Markahofmeister/PressurePulse_Brain-PCB/Project Outputs for PressurePulse_Brain-PCB/BOM/Bill of Materials-PressurePulse_Brain-PCB.xlsx

Comment | Designator | Footprint | JLCPCB PN
DNS | ANT1 | ANT_ANT7020LL05R0870A_PUL-L | DNS
BS-2-1 | BATT1 | BAT_BS-7 | C70376
100uF | C1 | CAP_POL_SMD | C336392
4.7uF | C2 | 0402C
4.7uF | C3 | 0402C
4.7uF | C4 | 0402C
100nF | C5 | 0402C
1uF | C6 | 0402C
1uF | C7 | 0402C
4.7uF | C8 | 0402C
4.7uF | C9 | 0402C
560pF | C10 | 0805C | C5186812
4.7uF | C11 | 0402C
22uF | C12 | 0805C | C45783
22uF | C13 | 0805C | C45783
4.7uF | C14 | 0402C
100nF | C15 | 0402C
100nF | C16 | 0402C
100nF | C17 | 0402C
1uF | C18 | 0402C
1uF | C19 | 0402C
100nF | C20 | 0402C
100nF | C21 | 0402C
4.7uF | C22 | 0402C
100nF | C23 | 0402C
0.8pF | C24 | 0603C | C907996
0.3pF | C25 | 0402C | C2986289
DNS | C26 | 0402C
10pF | C27 | 0402C | C328913
DNS | C28 | 0402C
10pF | C29 | 0402C | C328913
4.7uF | C30 | 0402C
100nF | C31 | 0402C
4.7uF | C32 | 0402C
560pF | C33 | 0402C
560pF | C34 | 0402C
4.7uF | C35 | 0402C
100nF | C36 | 0402C
100nF | C37 | 0402C
4.7uF | C38 | 0402C
100uF | C39 | CAP_POL_SMD | C336392
100uF | C40 | CAP_POL_SMD | C336392
4.7uF | C41 | 0402C
4.7uF | C42 | 0402C
4.7uF | C43 | 0402C
SSL24F | D1 | SMAF | C4749014
19-213/Y2C-CQ2R2L/3T(CY) | D3 | 0603-LED | C72038
D-060306B1 | D4 | 0603-LED | C118339
KT-0603R | D5 | 0603-LED | C2286
BDFN2C051V40 | D6 | BDFN2C051V40 | C152023
BDFN2C051V40 | D7 | BDFN2C051V40 | C152023
BDFN2C051V40 | D8 | BDFN2C051V40 | C152023
BDFN2C051V40 | D9 | BDFN2C051V40 | C152023
BDFN2C051V40 | D10 | BDFN2C051V40 | C152023
BDFN2C051V40 | D11 | BDFN2C051V40 | C152023
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
TPS613222ADBVR | U5 | SOT-23-5 | C2071163
STM32WB55RGV6 | U6 | VQFN-68 | C401505
MAX98357AETE+T | U7 | 16-WFQFN EXPOSED PAD | C910544
LIS3DHTR | U8 | 16-VFLGA | C15134
XRCMD32M000FXP50R0 | X1 | 32MHZ_SMD1612-4P | C341820
CM315D32768DZFT | X2 | XTAL_ECS-.327-12.5-34B-TR | C182057
