Markahofmeister/PressurePulse_Brain-PCB/PressurePulse_Brain-PCB.pdf

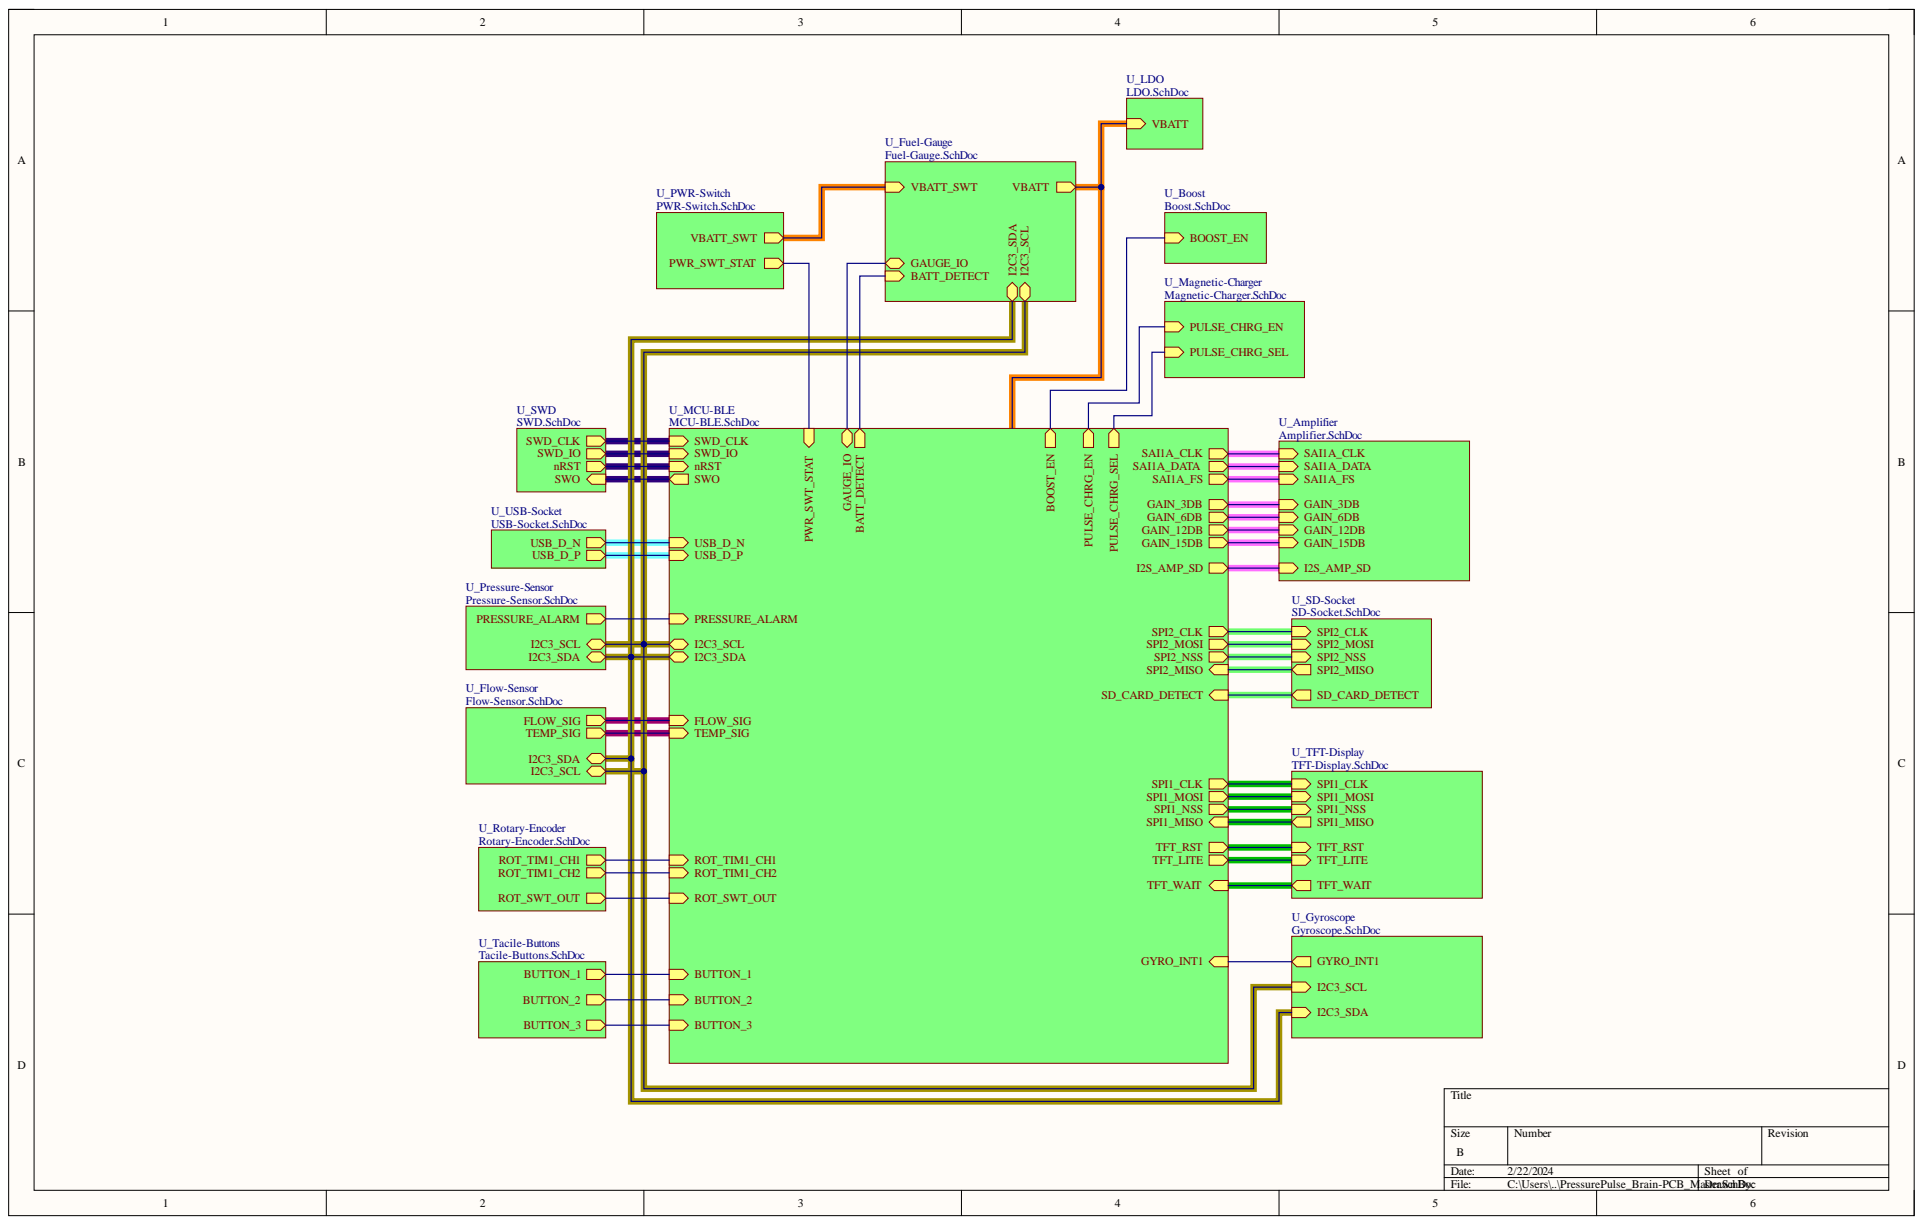
[picture p1: page 1]

Size B | Number | Revision

Date: 2/22/2024 | Sheet of
File: C:\Users\..\PressurePulse_Brain-PCB_MaDsterawr.Scn hBDy: oc

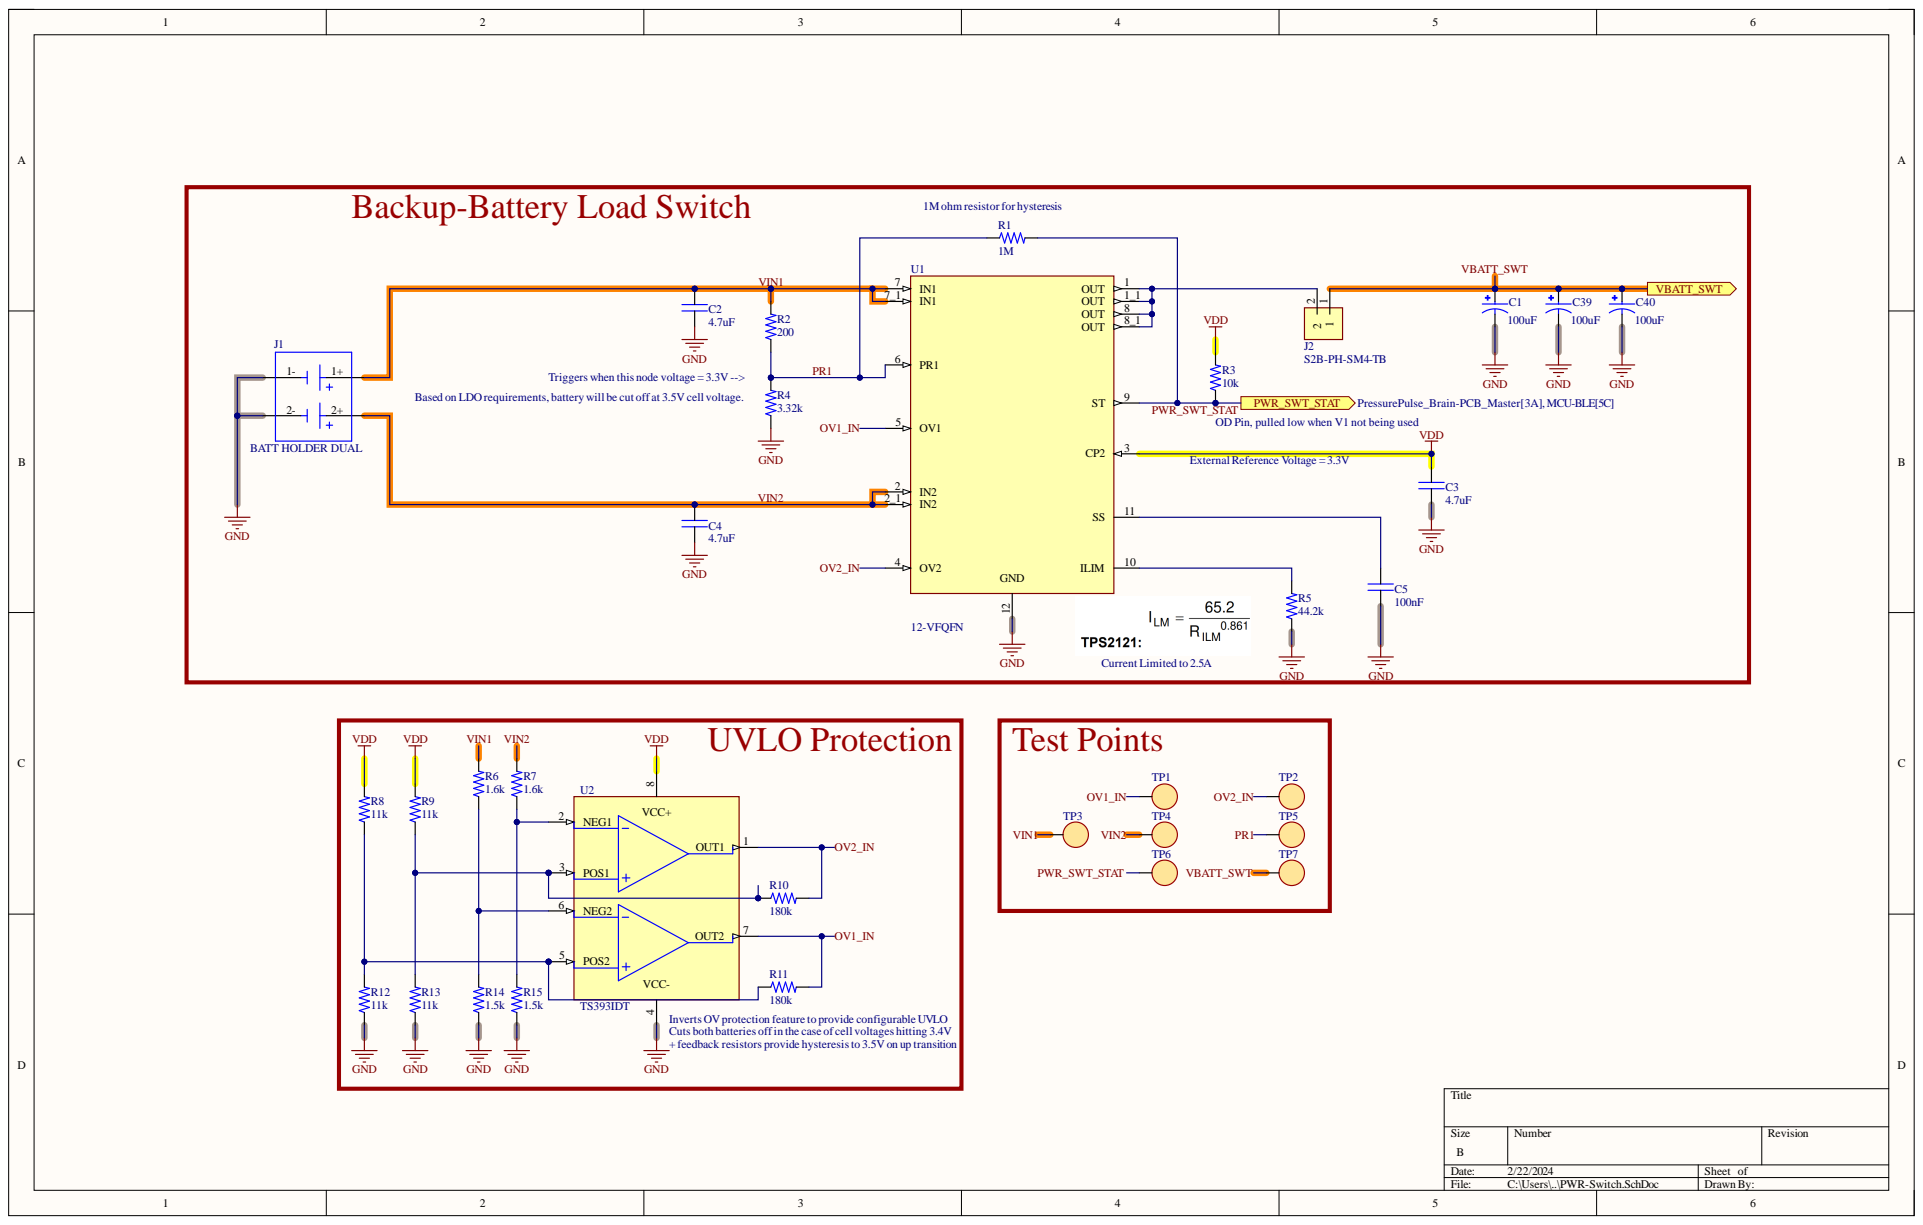
[picture p2: page 2]

Backup-Battery Load Switch

Triggers when this node voltage =3.3V -->

Based on LDOrequirements, battery will be cut off at 3.5V cell voltage.

OD Pin, pulled low when V1 not being used

Inverts OVprotection feature to provide configurable UVLO
Cuts both batteries off in the case of cell voltages hitting 3.4V
+feedback resistors provide hysteresisto 3.5V on up transition

Size B | Number | Revision

Date: 2/22/2024 | Sheet of
File: C:\Users\..\PWR-Switch.SchDoc | Drawn By:

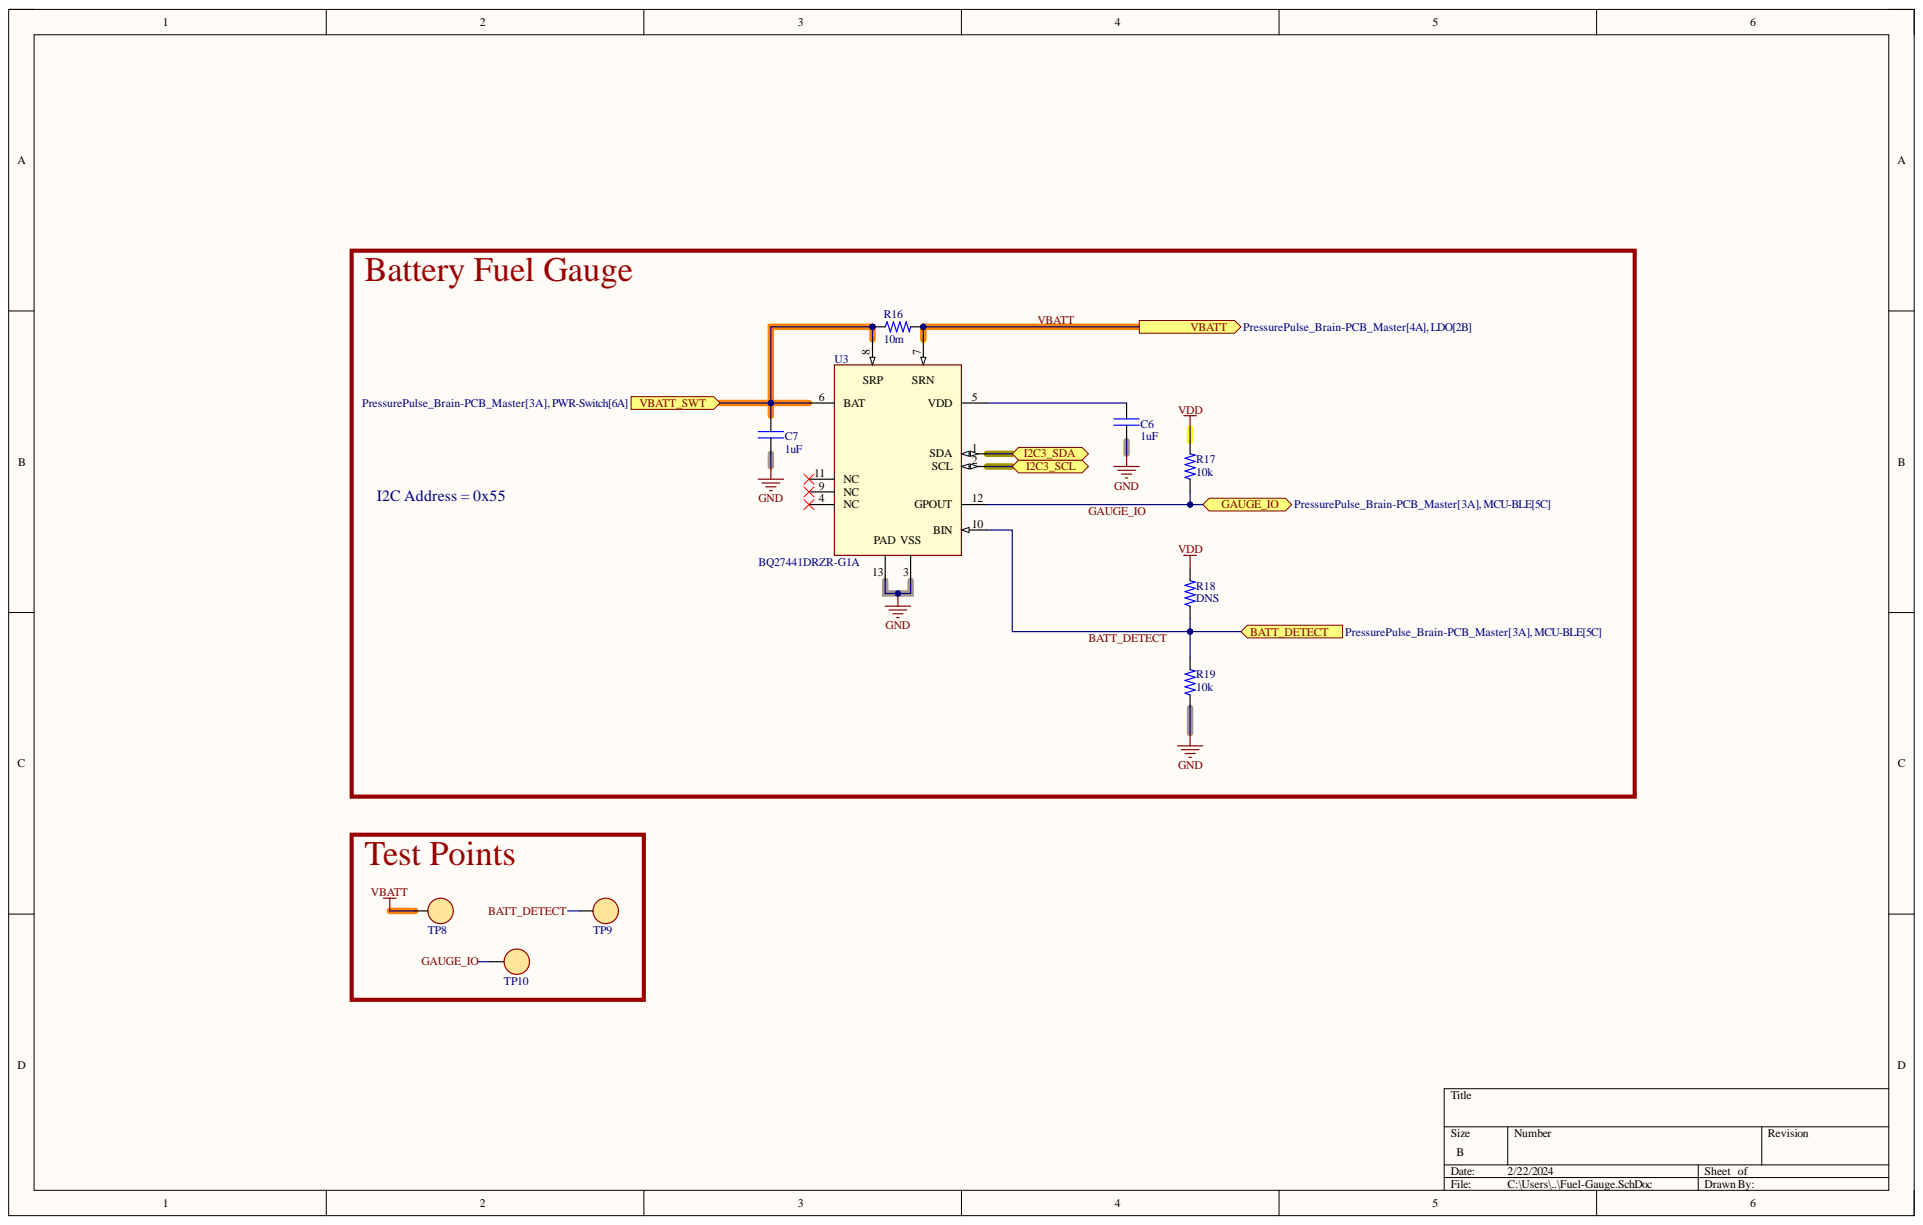
[picture p3: page 3]

Size B | Number | Revision

Date: 2/22/2024 | Sheet of
File: C:\Users\..\Fuel-Gauge.SchDoc | Drawn By:

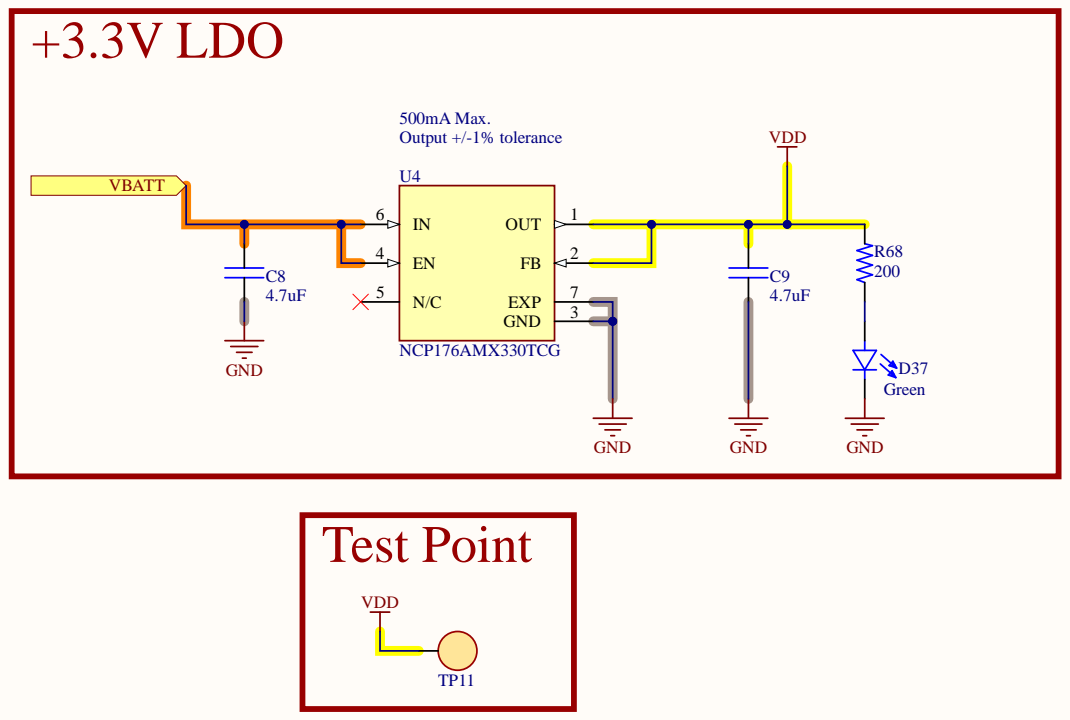
[picture p4: page 4]

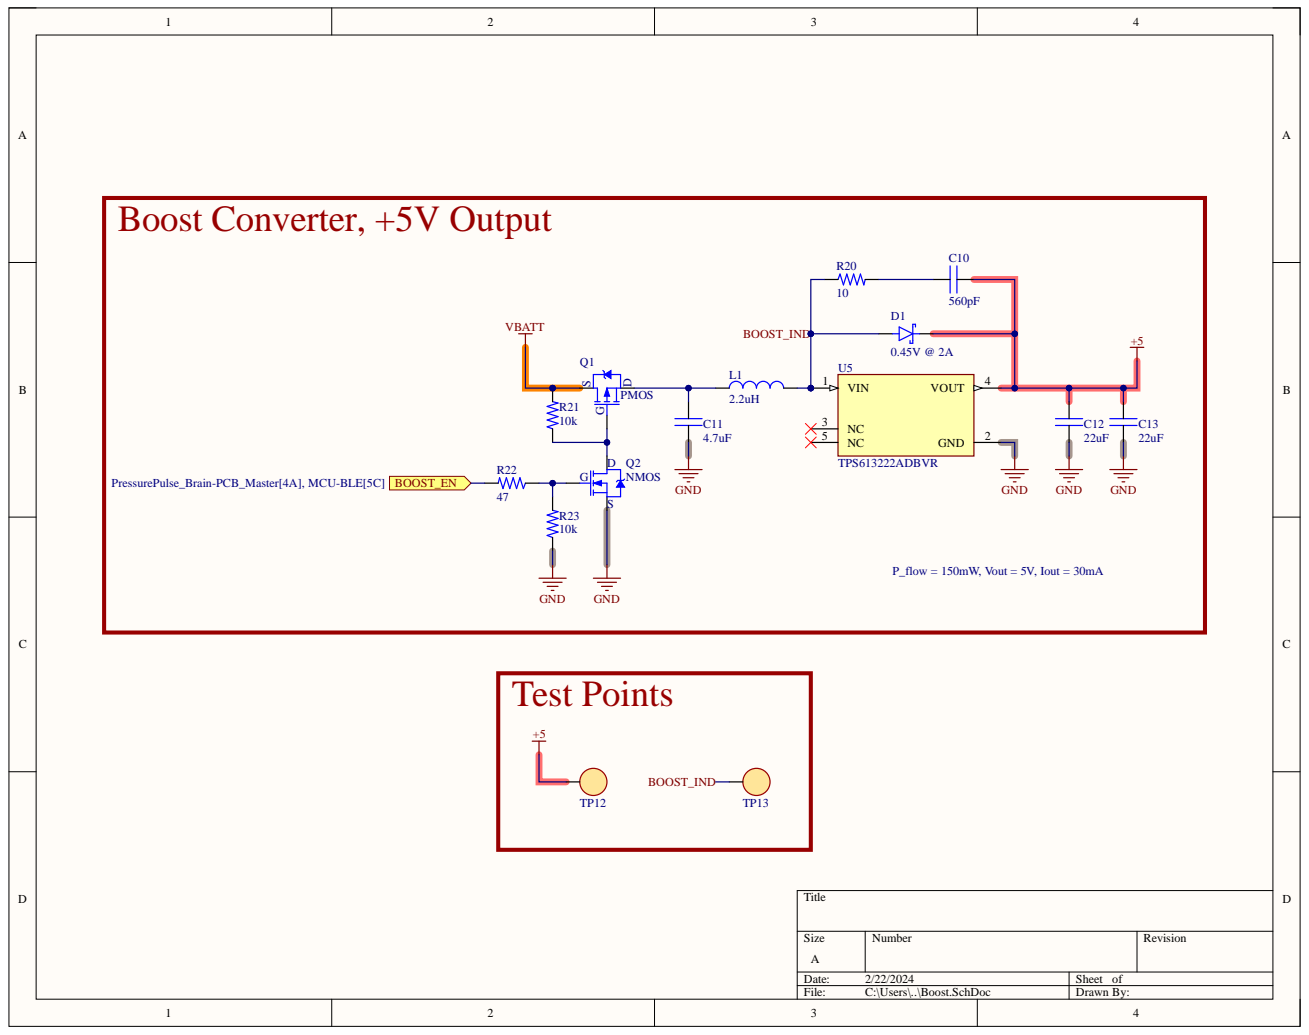
[picture p5: page 5]

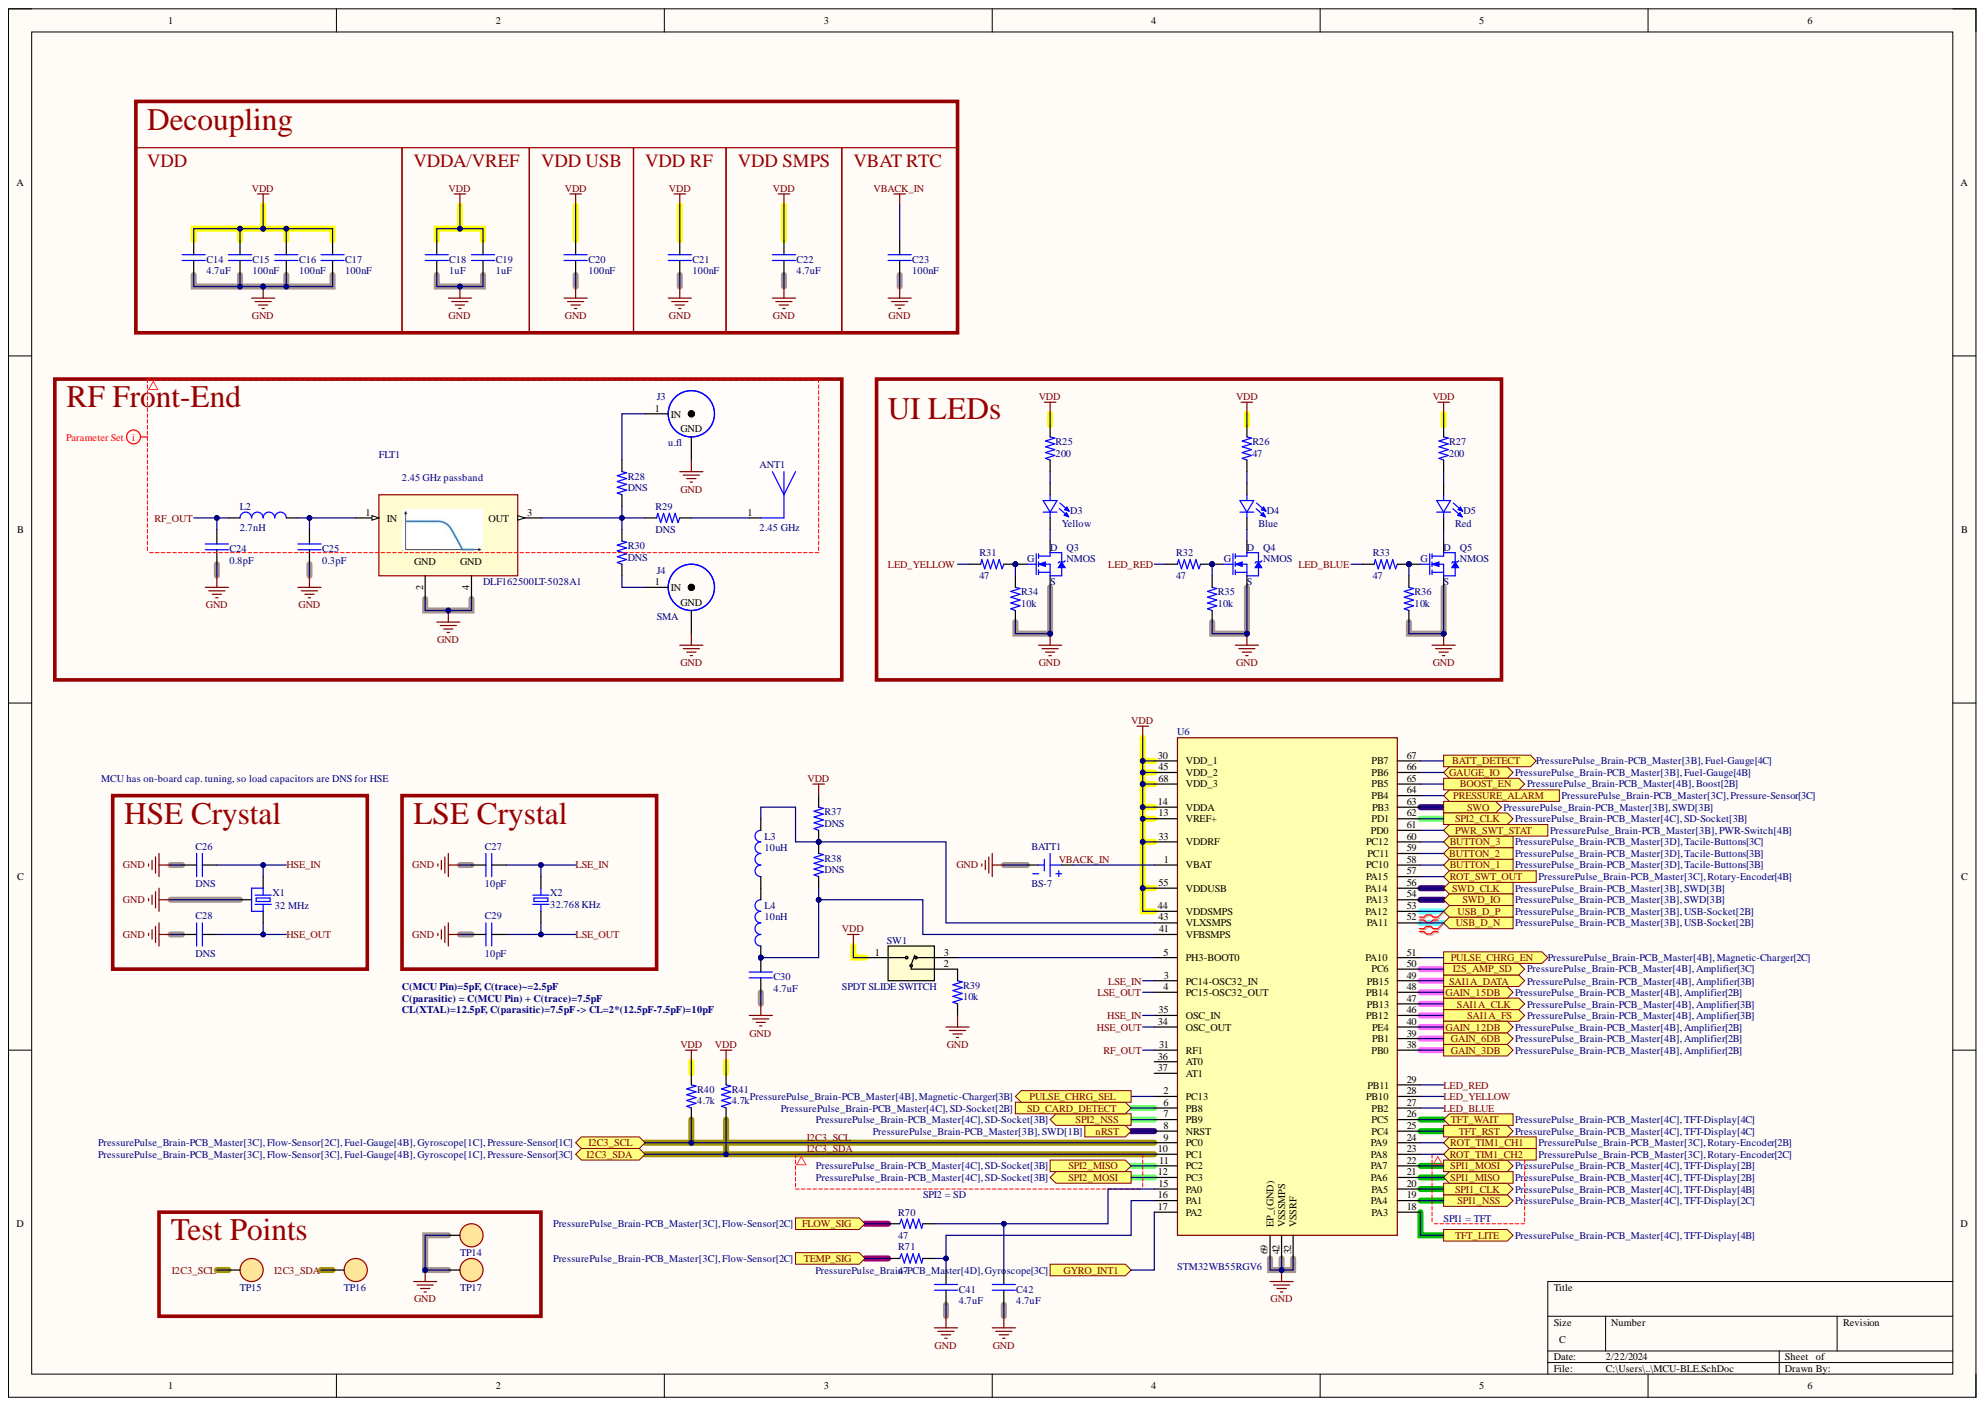
[picture p6: page 6]

MCU has on-board cap. tuning, so load capacitors are DNS for HSE

C(MCU Pin)=5pF, C(trace)~=2.5pF
C(parasitic) = C(MCU Pin) + C(trace)=7.5pF
CL(XTAL)=12.5pF, C(parasitic)=7.5pF -> CL=2*(12.5pF-7.5pF)=10pF

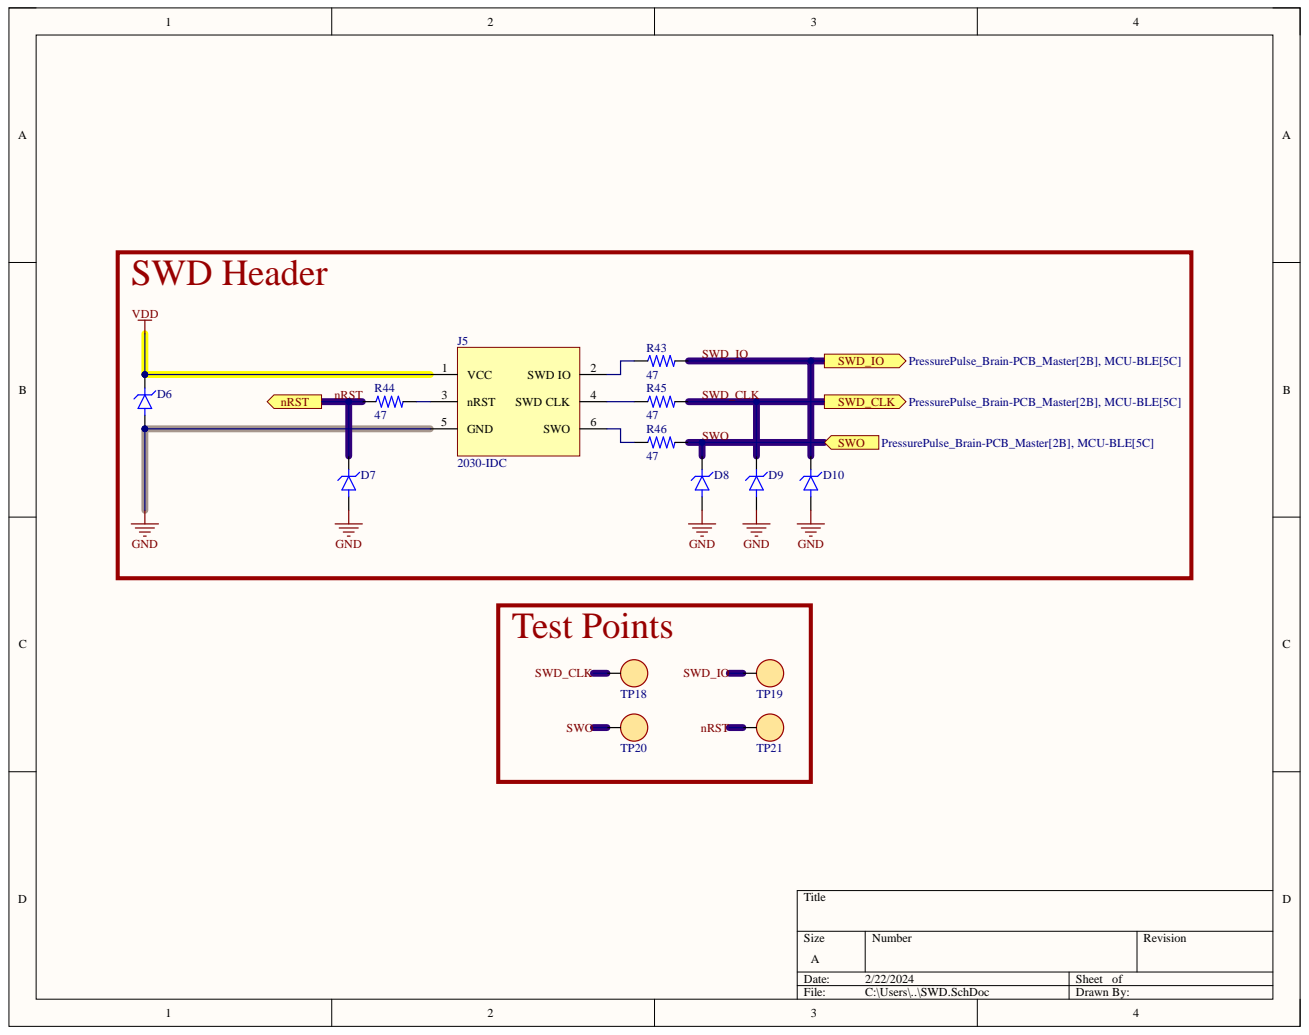
[picture p7: page 7]

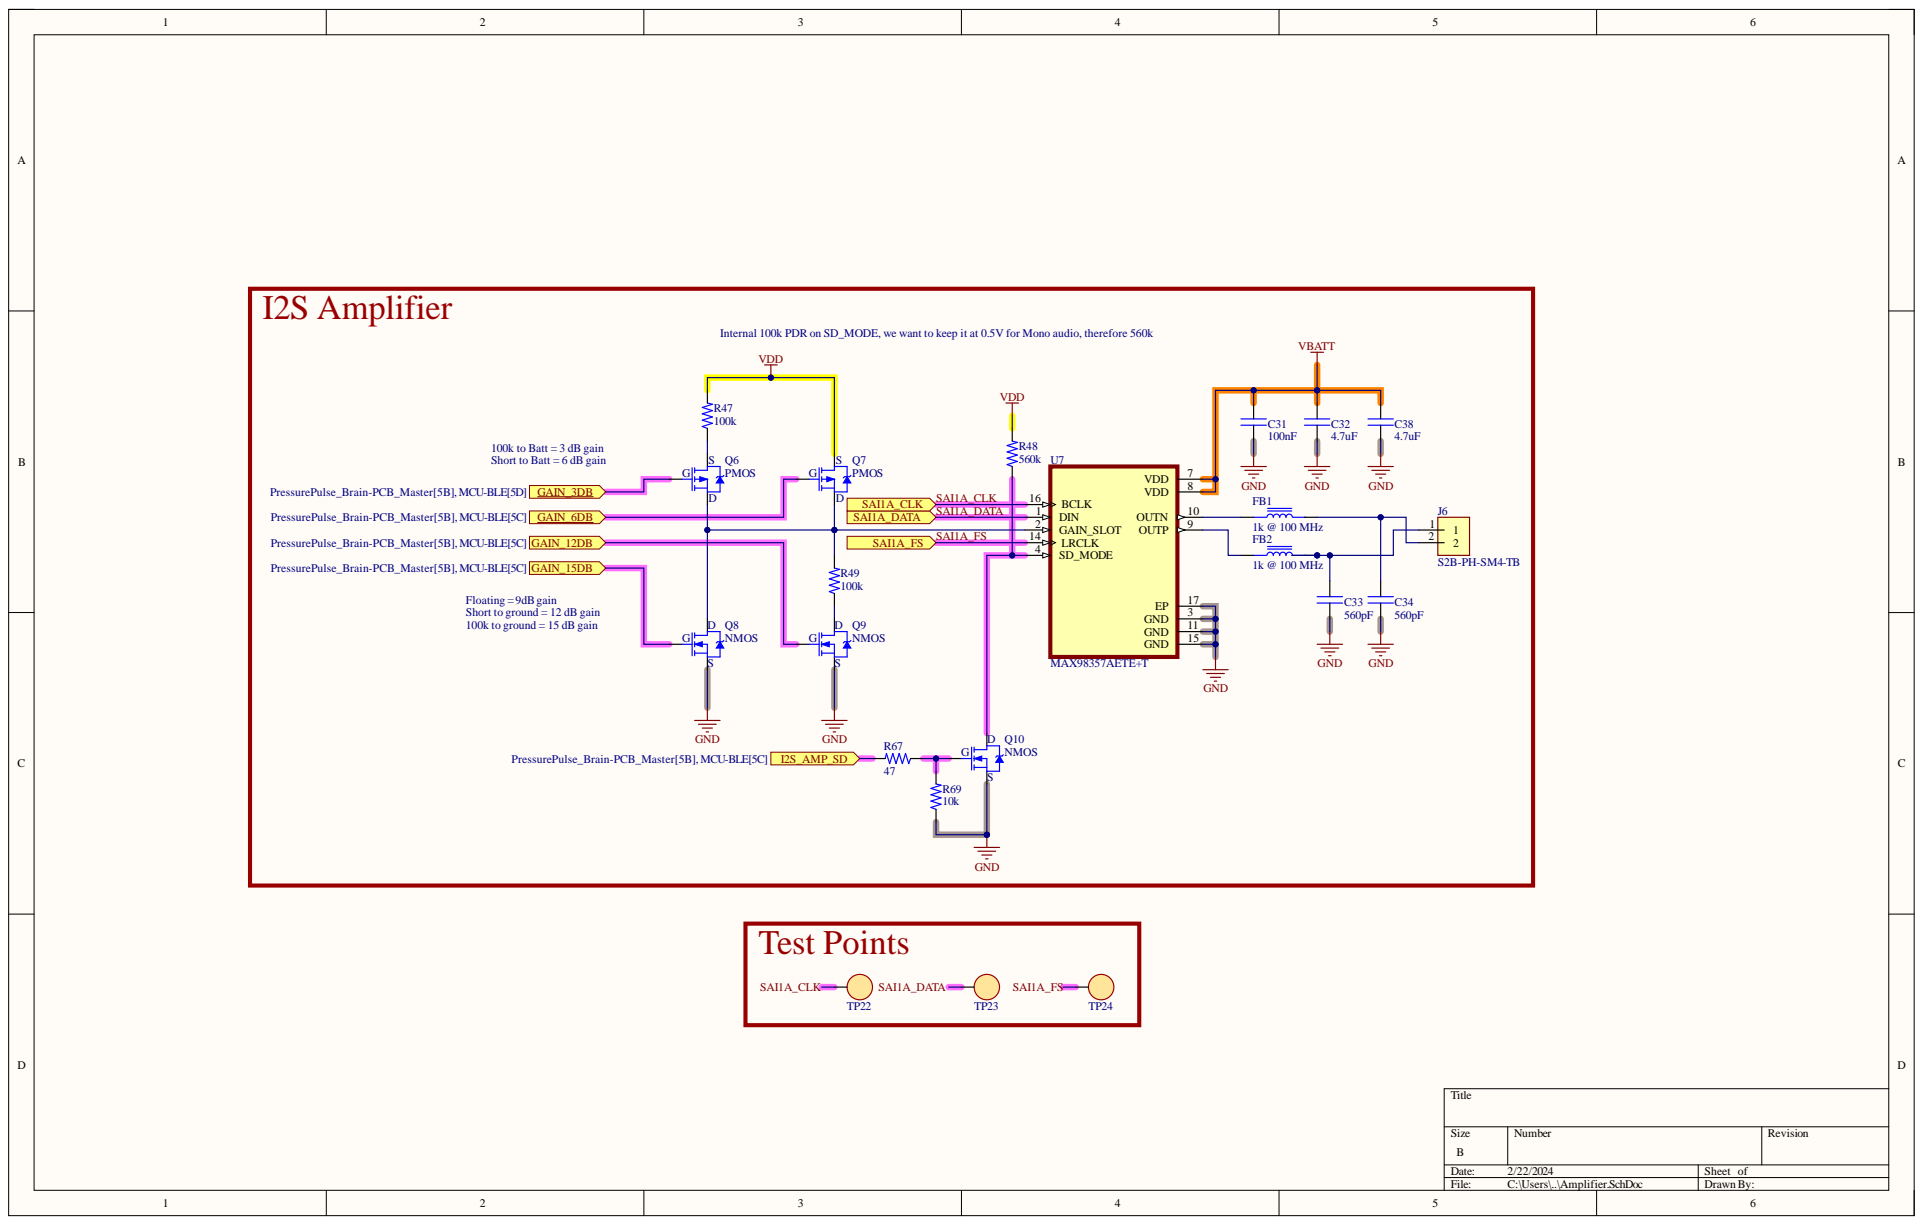
[picture p8: page 8]

Internal 100k PDR on SD_MODE, we want to keep it at 0.5V for Mono audio, therefore 560k

100k to Batt = 3 dB gain
Short to Batt = 6 dB gain

Floating =9dBgain
Short to ground = 12 dB gain
100k to ground = 15 dB gain

Size B | Number | Revision

Date: 2/22/2024 | Sheet of
File: C:\Users\..\Amplifier.SchDoc | Drawn By:

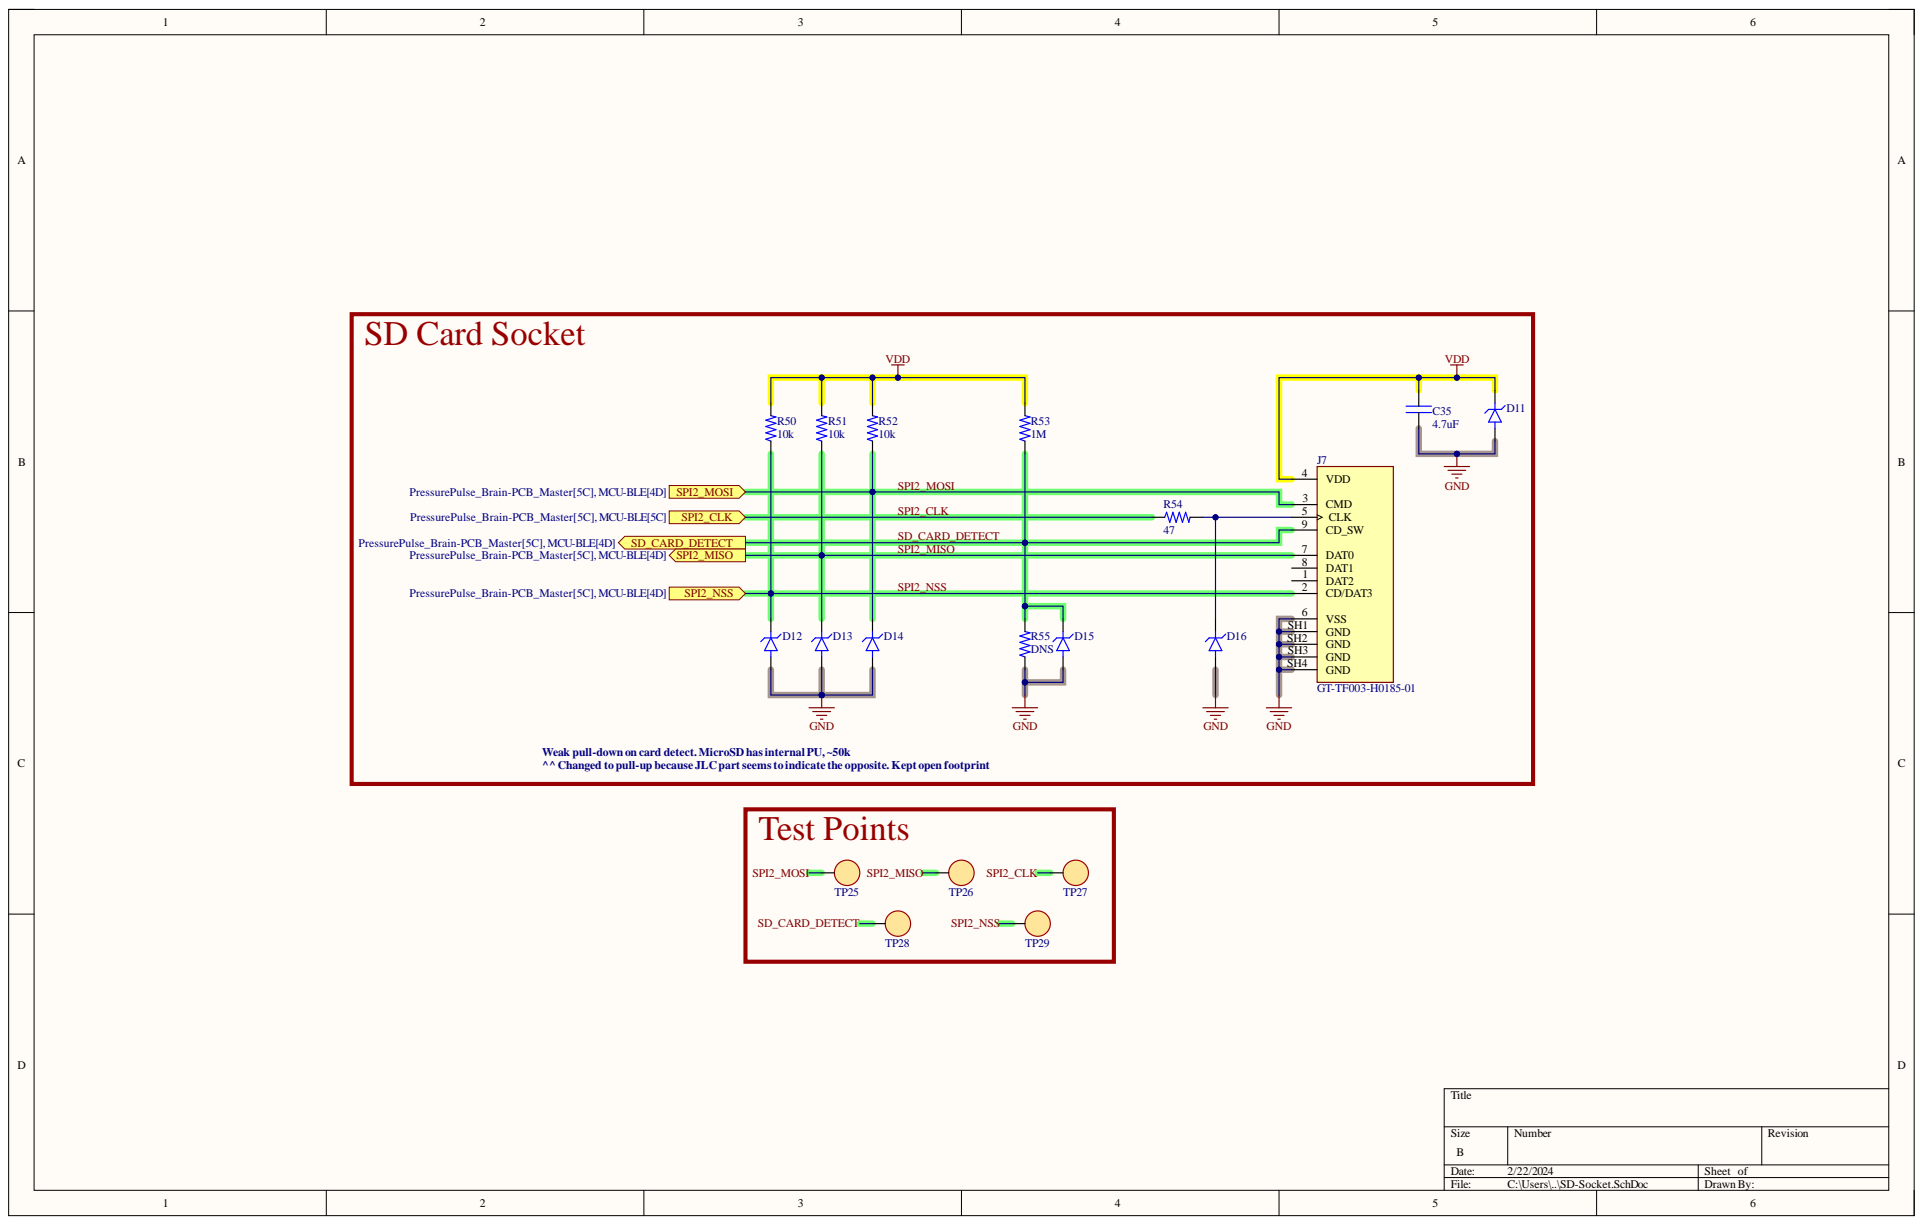
[picture p9: page 9]

SPI2_CLK SD_CARD_DETECT | | CLK 5 CD_SW 9

SPI2_MISO
SPI2_NSS | DAT1 8

DAT0 7

Weak pull-down on card detect. MicroSD hasinternal PU, ~50k
^^ Changed to pull-up because JLCpartseemsto indicate the opposite. Kept open footprint

Size B | Number | Revision

Date: 2/22/2024 | Sheet of
File: C:\Users\..\SD-Socket.SchDoc | Drawn By:

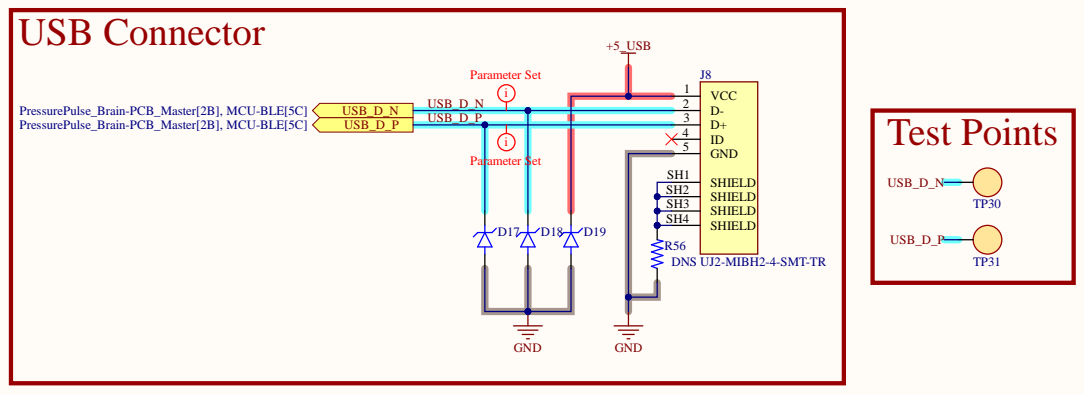
[picture p10: page 10]

S | H 1
S | H 2
S | H 3

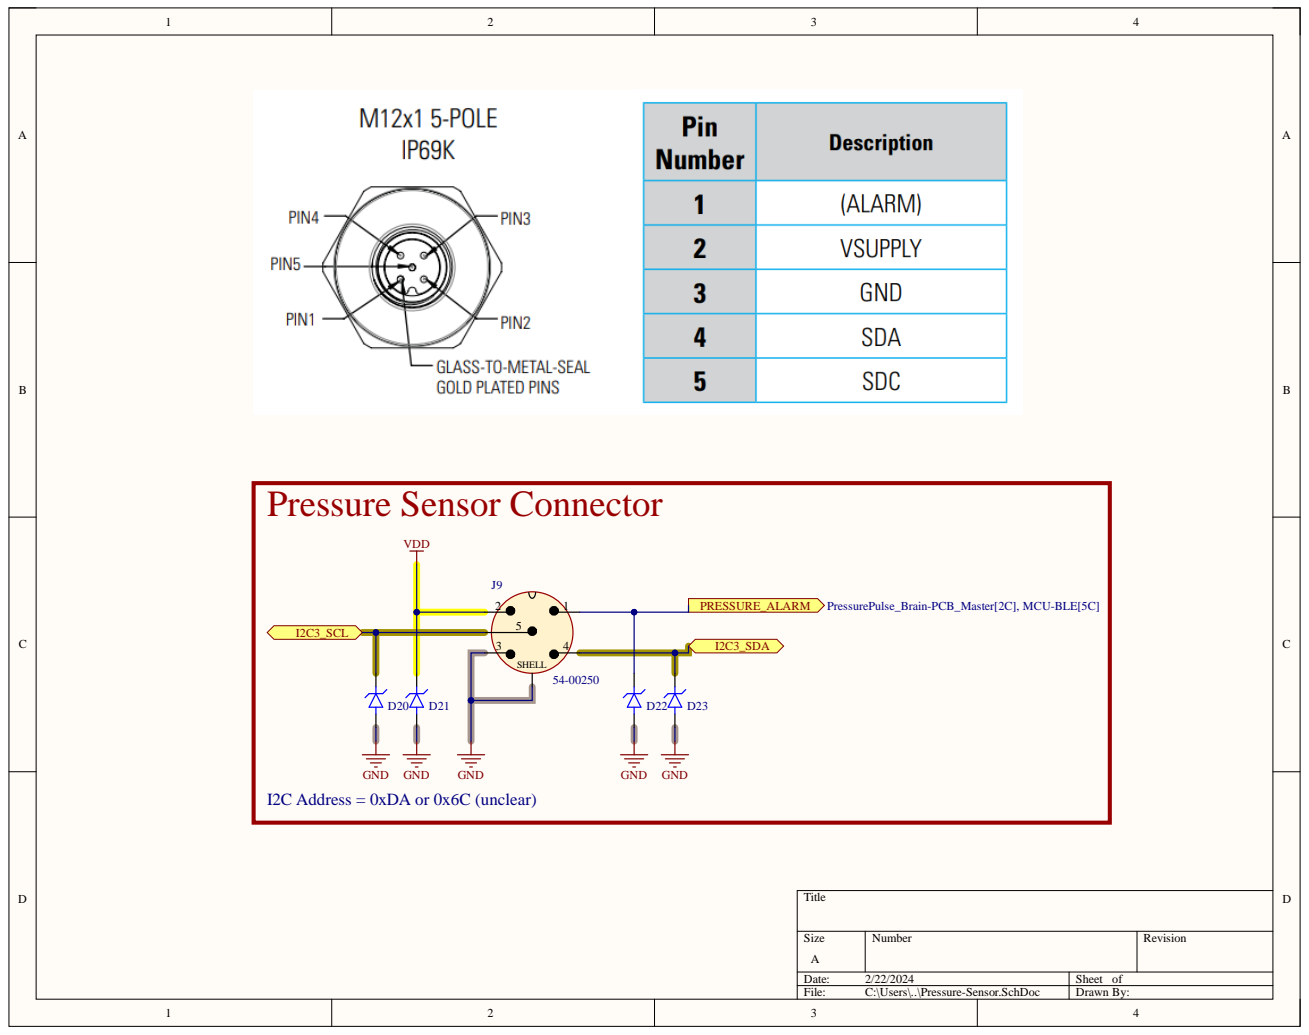
[picture p11: page 11]

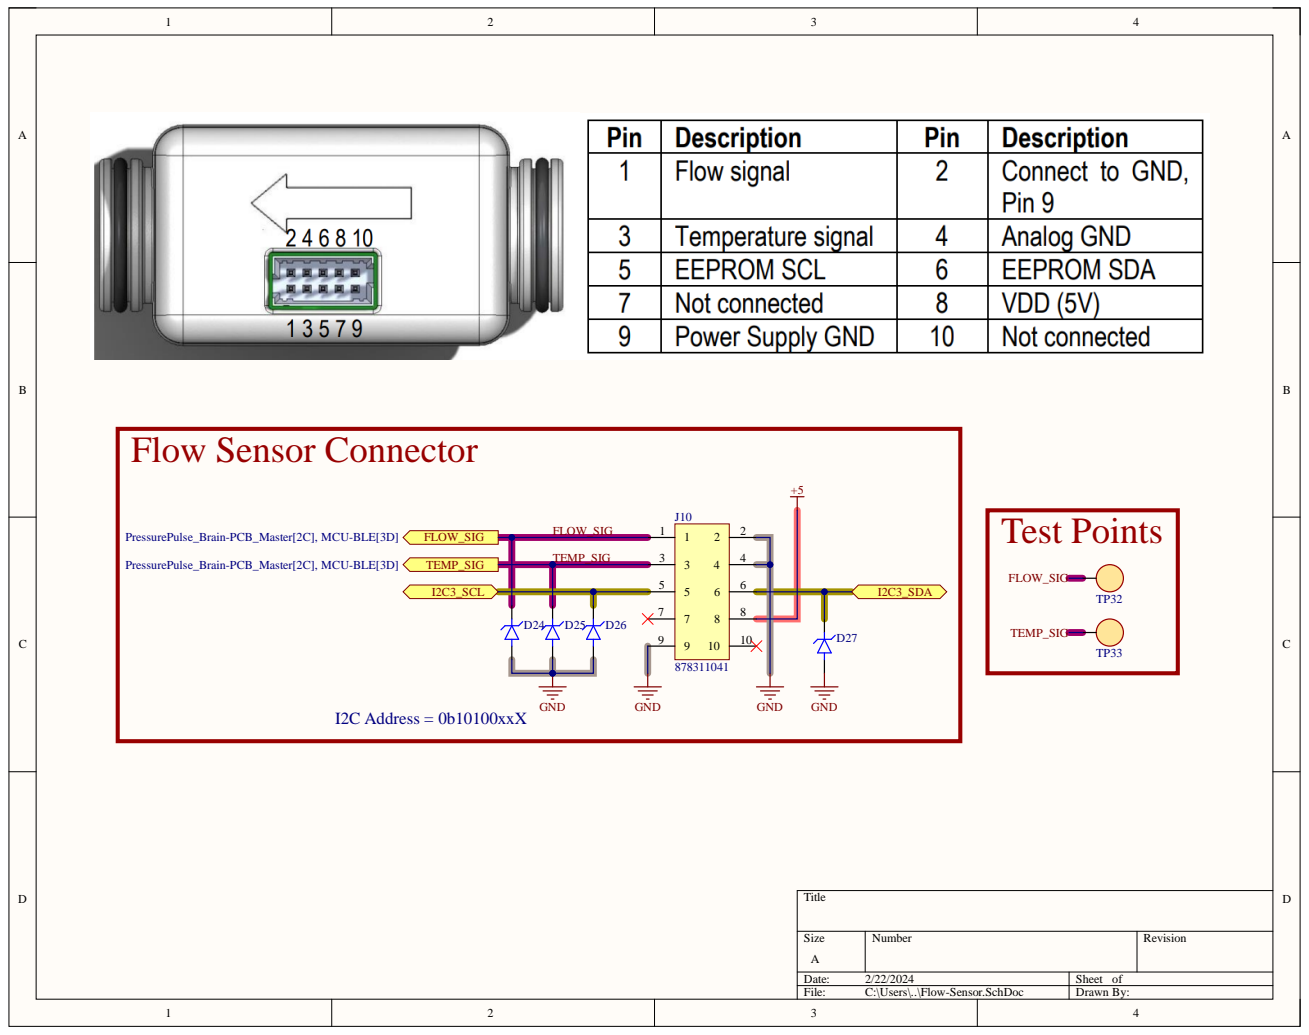
[picture p12: page 12]

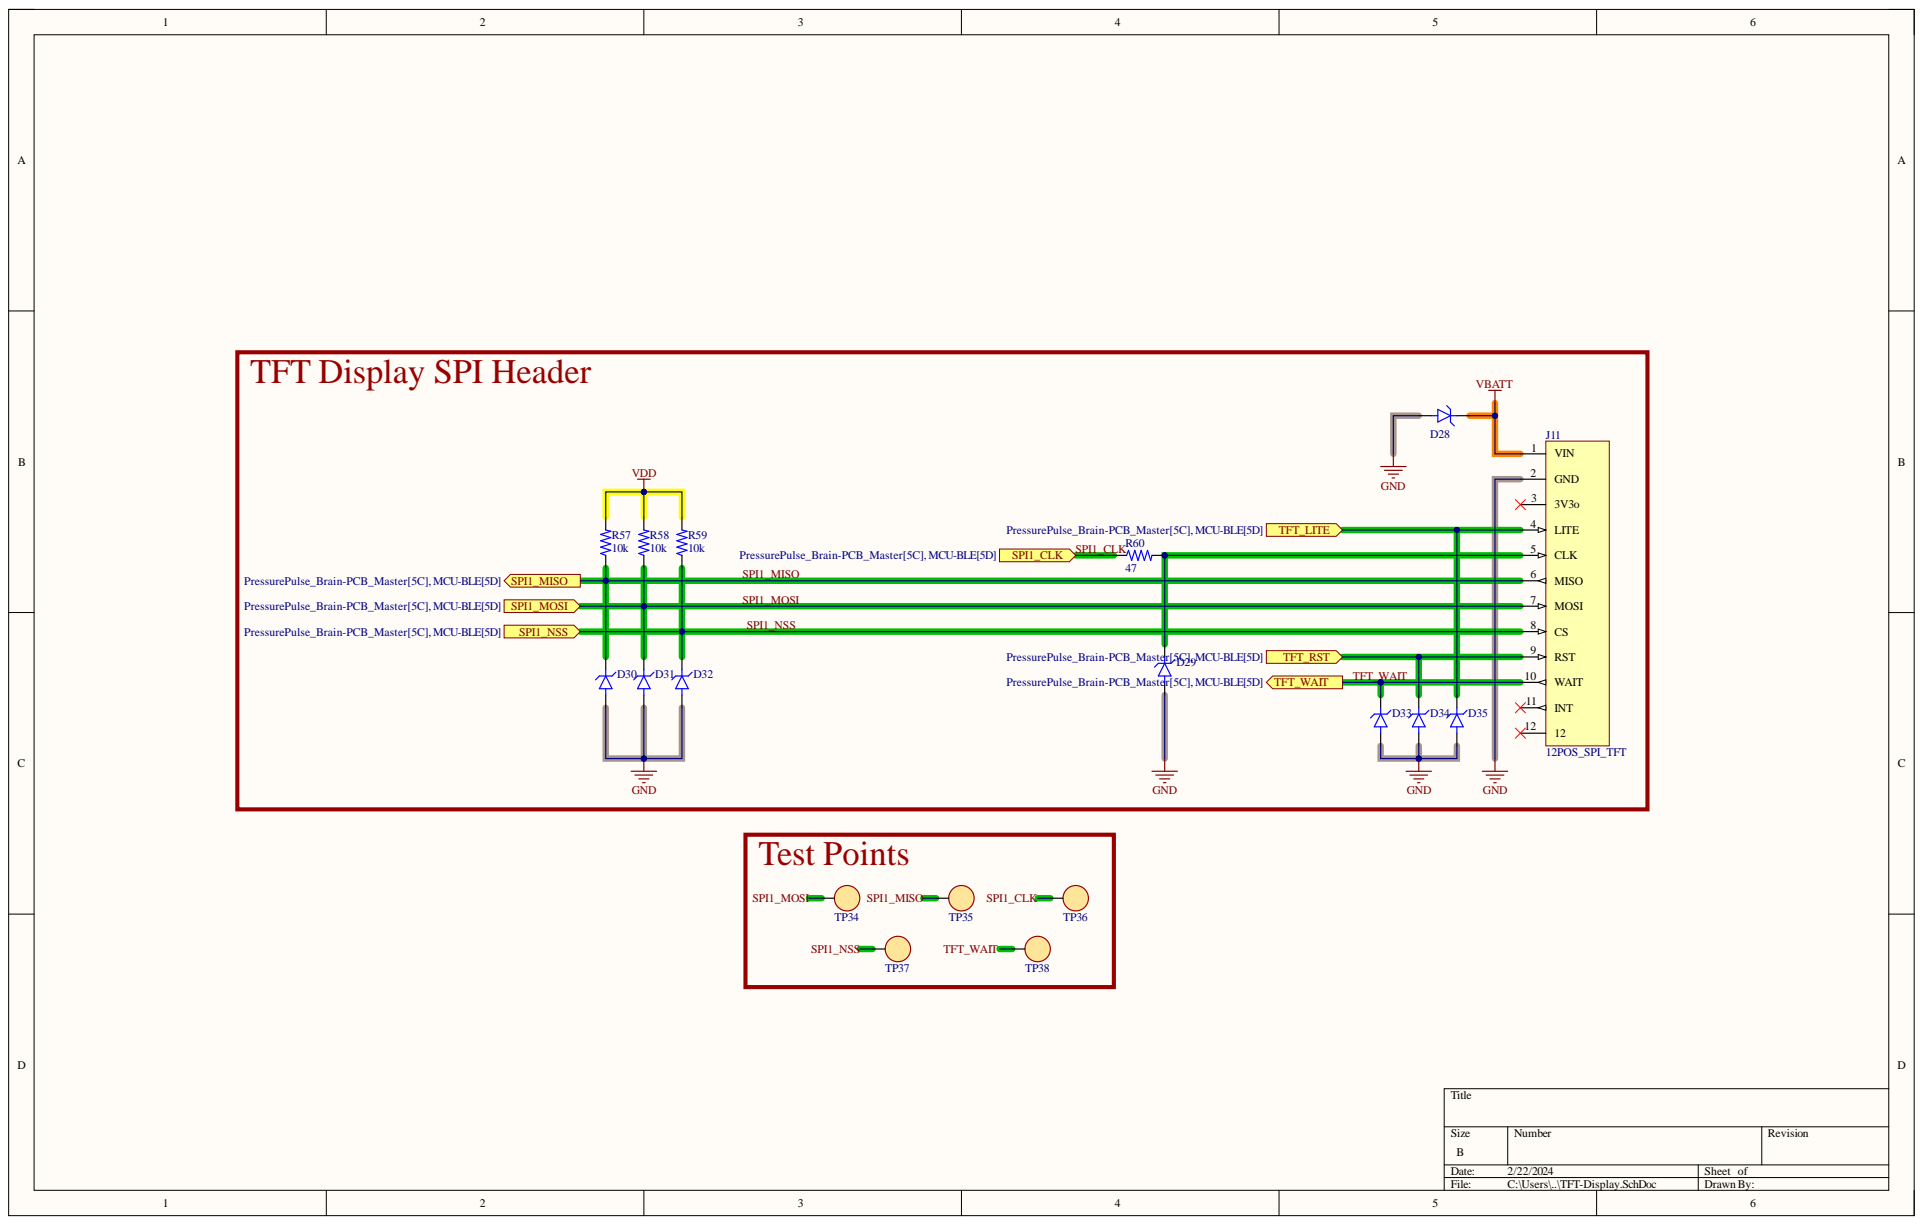
[picture p13: page 13]

TFT Display SPI Header

Size B | Number | Revision

Date: 2/22/2024 | Sheet of
File: C:\Users\..\TFT-Display.SchDoc | Drawn By:

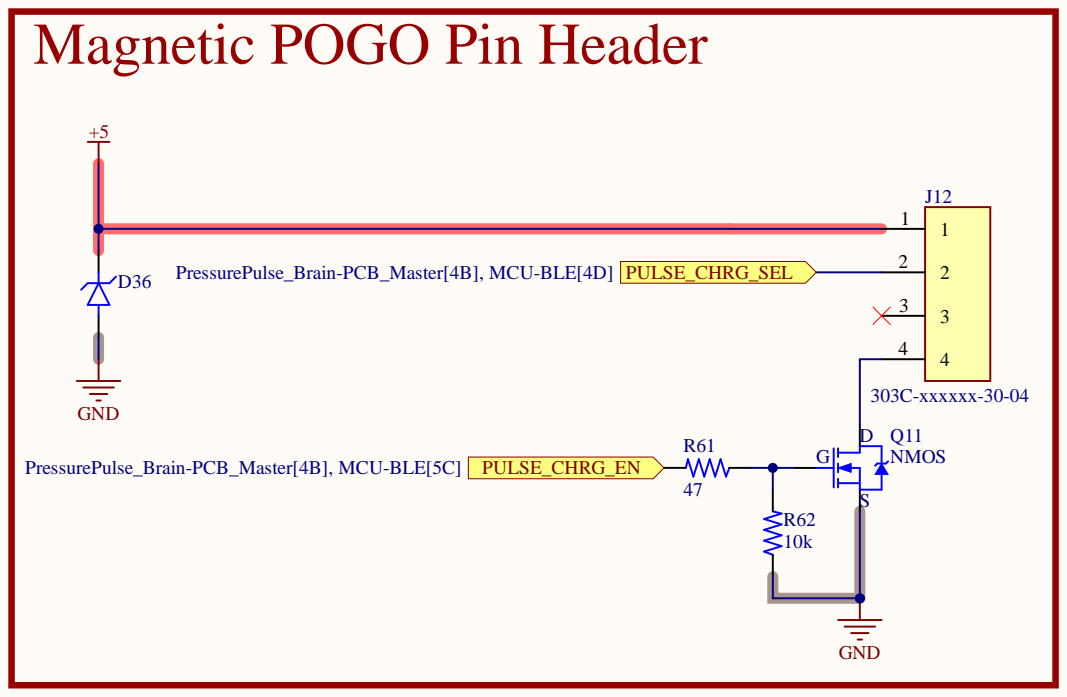
[picture p14: page 14]

Magnetic POGO Pin Header

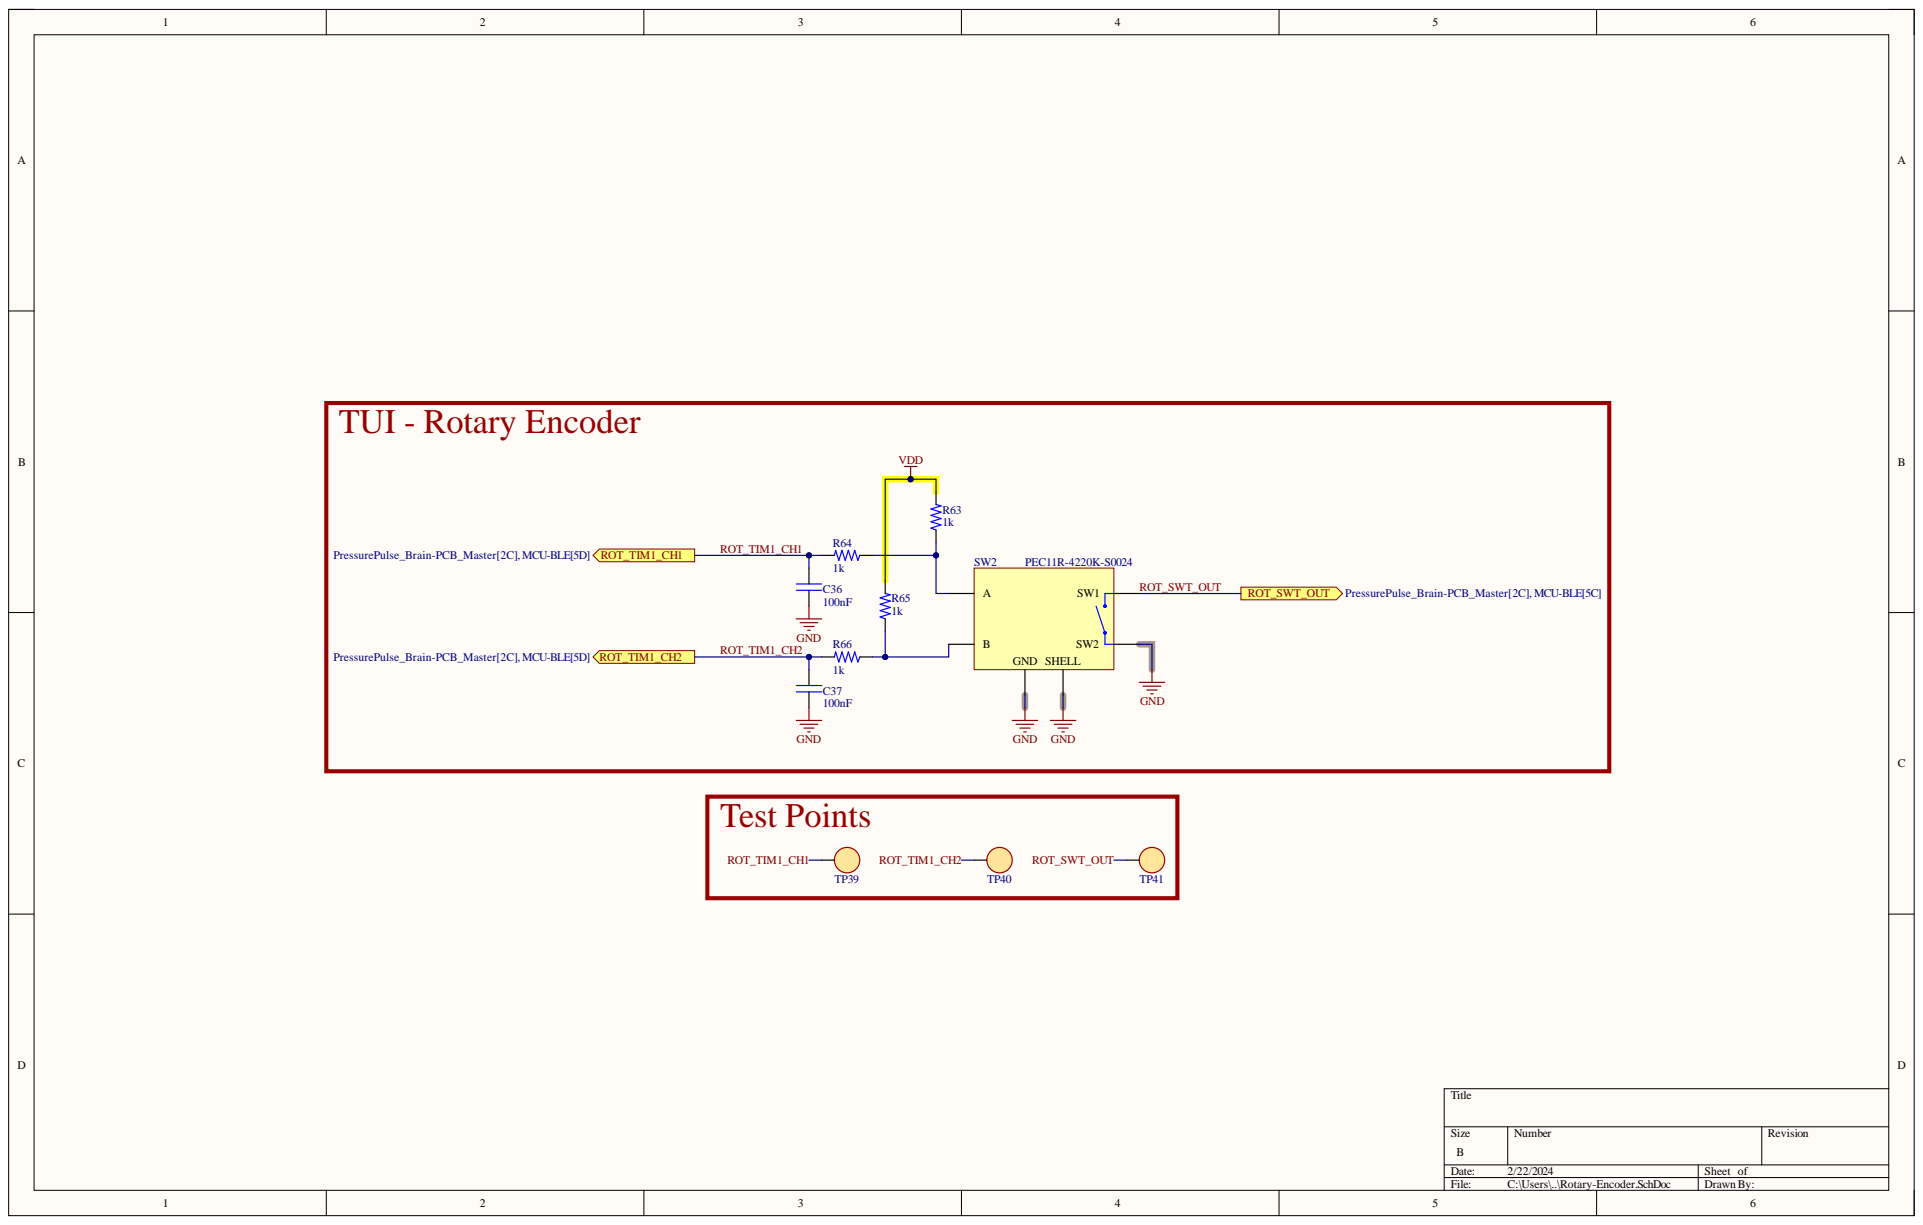
[picture p15: page 15]

Size B | Number | Revision

Date: 2/22/2024 | Sheet of
File: C:\Users\..\Rotary-Encoder.SchDoc | Drawn By:

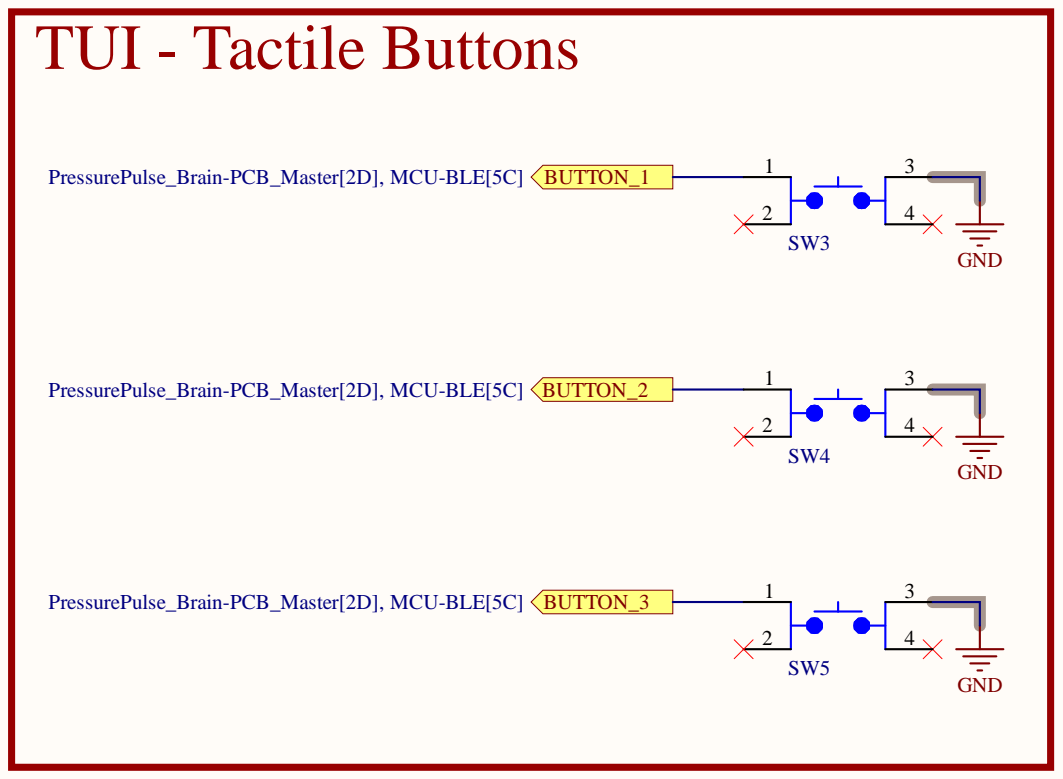
[picture p16: page 16]

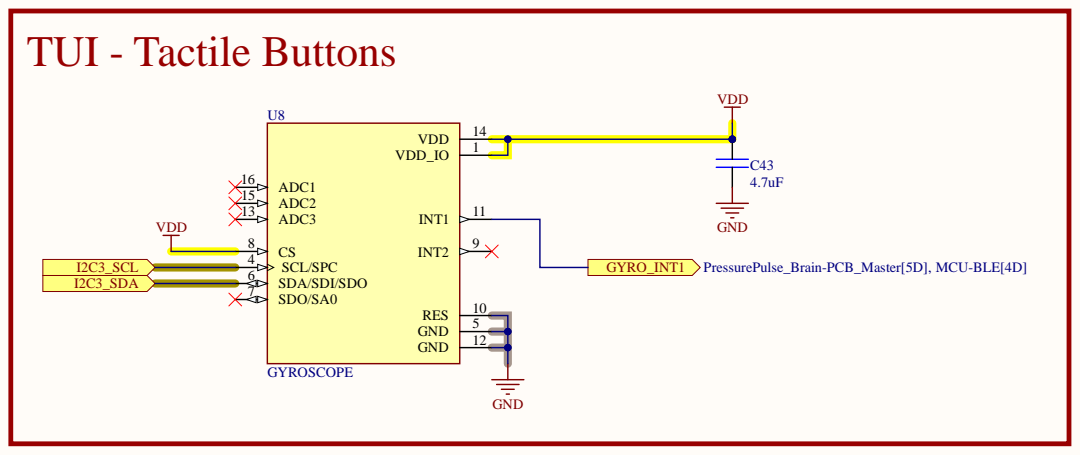
[picture p17: page 17]

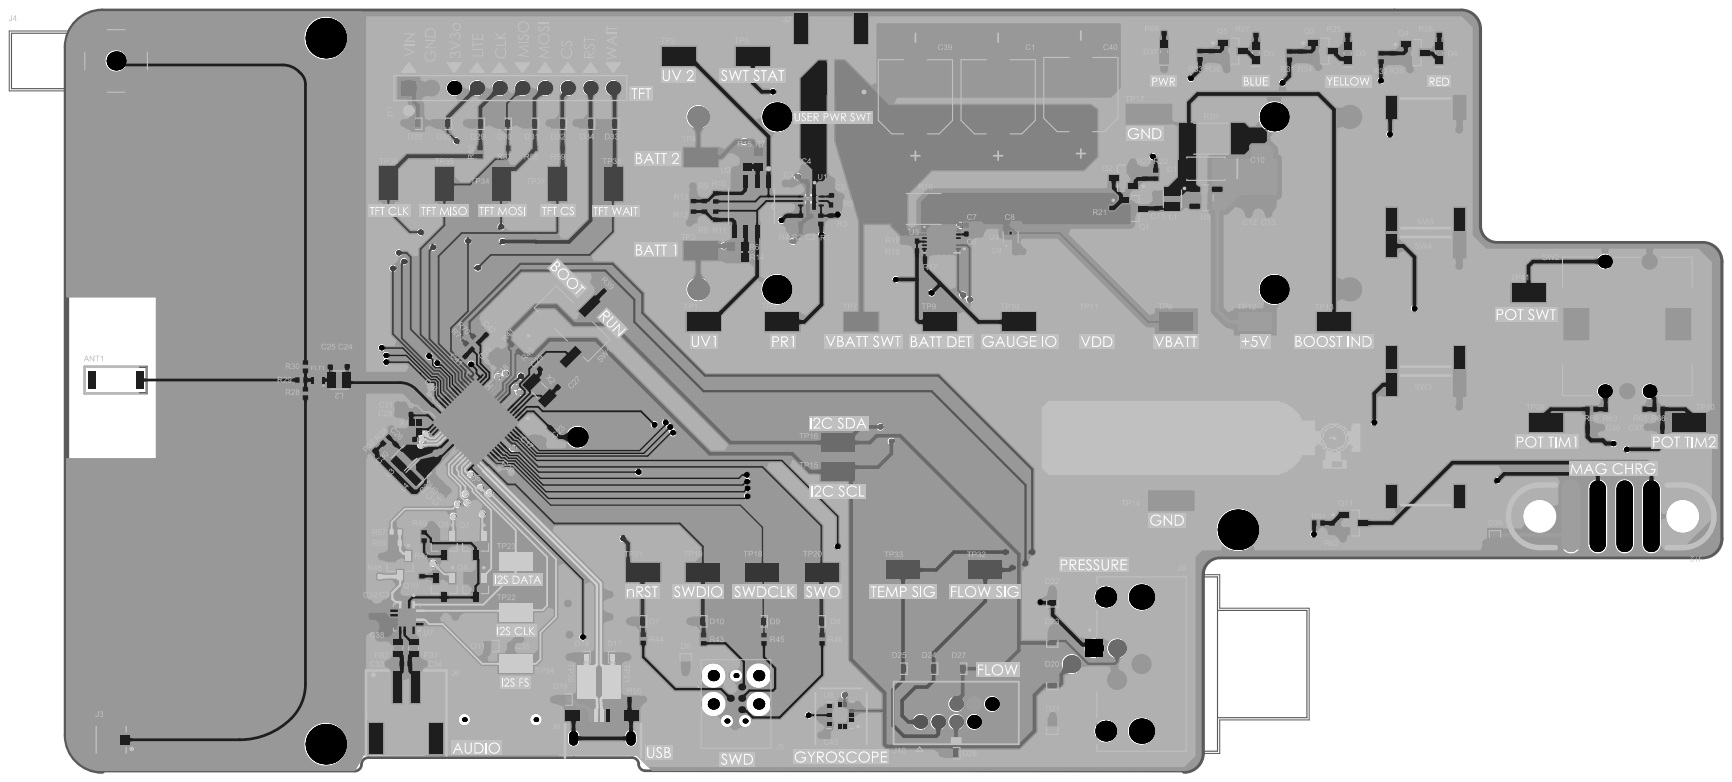
[picture p18: page 18]
