Markahofmeister/PressurePulse_Brain-PCB/(list of files, drawings)

Other design files:
6_USB-Socket.SchDoc
Amplifier.SchDoc
Boost.SchDoc
Flow-Sensor.SchDoc
Fuel-Gauge.SchDoc
Gyroscope.SchDoc
LDO.SchDoc
Magnetic-Charger.SchDoc
MCU-BLE.SchDoc
Pressure-Sensor.SchDoc
PressurePulse_Brain-PCB.PrjPcb
PressurePulse_Brain-PCB_Master.SchDoc
PWR-Switch.SchDoc
Rotary-Encoder.SchDoc
SD-Socket.SchDoc
SWD.SchDoc
Tacile-Buttons.SchDoc
TFT-Display.SchDoc
USB-Socket.SchDoc
