Markahofmeister/PressurePulse_Brain-PCB/(commit log)

2024-01-22 Initial Commit - Create Altium Project
    [PressurePulse_Brain-PCB.PrjPcb]
2024-01-22 Update .gitignore to ignore history
    [PressurePulse_Brain-PCB.PrjPcb]
2024-01-26 Add preliminary BLE MCU Schematic, may swap for lower pin count later
    [1_MCU-BLE.SchDoc, PressurePulse_Brain-PCB.PrjPcb]
2024-01-27 Add completed I2S amplifier. I will make this a hierarchical design
    [2_MCU-BLE.SchDoc]
2024-01-27 Finish SD card schem
    [4_Amplifier.SchDoc, 5_OB-Connectors.SchDoc, PressurePulse_Brain-PCB.PrjPcb, PressurePulse_Brain-PCB_Master.SchDoc]
2024-01-27 Moving to just SD socket on schem
    [5_OB-Connectors.SchDoc]
2024-01-27 Rename to just SD socket
    [5_SD-Socket.SchDoc]
2024-02-04 Add SWD and USB socket schematics
    [2_MCU-BLE.SchDoc, 3_MCU-Proc.SchDoc, 3_SWD.SchDoc, 5_SD-Socket.SchDoc, PressurePulse_Brain-PCB.PrjPcb, USB-Socket.SchDoc]
2024-02-04 Add new sensor/connector schematics. Flow sensor will need 5V - boost added to BLE MCU schem
    [10_Temp-Sensor.SchDoc, 11_Altitude-Sensor.SchDoc, 1_PWR.SchDoc, 2_MCU-BLE.SchDoc, 3_SWD.SchDoc, 4_Amplifier.SchDoc, 6_USB-Socket.SchDoc, 8_Pressure-Sensor.SchDoc]
2024-02-06 Add complete Boost converter circuit (I think)
    [1_PWR.SchDoc]
2024-02-07 Finish flow sensor and pressure sensor connectors, finish boost converter
    [12_Boost.SchDoc, 1_PWR.SchDoc, 2_MCU-BLE.SchDoc, 8_Pressure-Sensor.SchDoc, 9_Flow-Sensor.SchDoc, PressurePulse_Brain-PCB.PrjPcb]
2024-02-08 Finish PWR switch schematic. However, reference voltage divider issue must be solved.
    [1_PWR-Switch.SchDoc]
2024-02-08 Select & Add LDO to schematic, change to new power switch.
    [1_PWR-Switch.SchDoc, LDO.SchDoc, PressurePulse_Brain-PCB.PrjPcb]
2024-02-09 Finish most of power switch circuit
    [1_PWR-Switch.SchDoc]
2024-02-11 Finish RF section, chosen JLC components and added chip antenna output
    [1_PWR-Switch.SchDoc, 2_MCU-BLE.SchDoc, LDO.SchDoc]
2024-02-12 Temp and altitude sensor likely not needed. Add backup battery to MCU.
    [10_Temp-Sensor.SchDoc, 11_Altitude-Sensor.SchDoc, 1_PWR-Switch.SchDoc, 2_MCU-BLE.SchDoc, PressurePulse_Brain-PCB.PrjPcb]
2024-02-12 Remove numbers from schematic file names
    [Amplifier.SchDoc, Boost.SchDoc, Flow-Sensor.SchDoc, MCU-BLE.SchDoc, PWR-Switch.SchDoc, Pressure-Sensor.SchDoc, PressurePulse_Brain-PCB.PrjPcb, SD-Socket.SchDoc]
2024-02-12 Add fuel gauge, hack in UVLO feature on load switch
    [Boost.SchDoc, Cell-Protection.SchDoc, Fuel-Gauge.SchDoc, PWR-Switch.SchDoc, PressurePulse_Brain-PCB.PrjPcb]
2024-02-12 Comments to power switch.
    [Cell-Protection.SchDoc, PWR-Switch.SchDoc]
2024-02-13 Add completed TFT Display Connector and pins to MCU
    [Fuel-Gauge.SchDoc, MCU-BLE.SchDoc, PWR-Switch.SchDoc, Pressure-Sensor.SchDoc, PressurePulse_Brain-PCB.PrjPcb, SD-Socket.SchDoc, TFT-Display.SchDoc]
2024-02-14 Add magnetic charger for wearable
    [Amplifier.SchDoc, Magnetic-Charger.SchDoc, PressurePulse_Brain-PCB.PrjPcb]
2024-02-14 Add rotary encoder and buttons with MCU pins. About to add test points FR!
    [Flow-Sensor.SchDoc, Fuel-Gauge.SchDoc, LDO.SchDoc, MCU-BLE.SchDoc, Magnetic-Charger.SchDoc, PWR-Switch.SchDoc, Pressure-Sensor.SchDoc, PressurePulse_Brain-PCB.PrjPcb]
2024-02-15 Add test points to all relevant signals in each schematic
    [Amplifier.SchDoc, Boost.SchDoc, Flow-Sensor.SchDoc, Fuel-Gauge.SchDoc, LDO.SchDoc, MCU-BLE.SchDoc, PWR-Switch.SchDoc, Pressure-Sensor.SchDoc]
2024-02-15 We are out of IO
    [MCU-BLE.SchDoc]
2024-02-15 Add net colors
    [Amplifier.SchDoc, Flow-Sensor.SchDoc, Fuel-Gauge.SchDoc, MCU-BLE.SchDoc, Magnetic-Charger.SchDoc, PWR-Switch.SchDoc, Pressure-Sensor.SchDoc, PressurePulse_Brain-PCB.PrjPcb]
2024-02-15 Annotate all schematic
    [Amplifier.SchDoc, Boost.SchDoc, Flow-Sensor.SchDoc, Fuel-Gauge.SchDoc, LDO.SchDoc, MCU-BLE.SchDoc, Magnetic-Charger.SchDoc, PWR-Switch.SchDoc]
2024-02-15 Fix holes in BOM
    [Amplifier.SchDoc, Boost.SchDoc, Fuel-Gauge.SchDoc, MCU-BLE.SchDoc, Magnetic-Charger.SchDoc, PWR-Switch.SchDoc, PressurePulse_Brain-PCB.PrjPcb, SD-Socket.SchDoc]
2024-02-19 Add Gyroscope
    [Amplifier.SchDoc, Boost.SchDoc, Gyroscope.SchDoc, LDO.SchDoc, MCU-BLE.SchDoc, PWR-Switch.SchDoc, PressurePulse_Brain-PCB.PrjPcb, PressurePulse_Brain-PCB_Master.SchDoc]
2024-02-19 Layout all rooms except for MCU and magnetic charger.
    [Amplifier.SchDoc, Fuel-Gauge.SchDoc, Gyroscope.SchDoc, PWR-Switch.SchDoc, PressurePulse_Brain-PCB.PrjPcb, PressurePulse_Brain-PCB_Master.SchDoc, TFT-Display.SchDoc]
2024-02-20 TFT connector MUST NOT CHANGE POSITION w.r.t. mounting hole.
    [Amplifier.SchDoc, Boost.SchDoc, MCU-BLE.SchDoc, PWR-Switch.SchDoc, PressurePulse_Brain-PCB.PrjPcb]
2024-02-20 SD and USB still need routed, as does some power lines.
    [MCU-BLE.SchDoc, PressurePulse_Brain-PCB.PrjPcb]
2024-02-21 Routing coming along
    [MCU-BLE.SchDoc, PressurePulse_Brain-PCB.PrjPcb, Tacile-Buttons.SchDoc, USB-Socket.SchDoc]
2024-02-21 Laid PWR/GND planes, begun to route power. Magnetic charger and a couple of power control lines still need routed.
    [MCU-BLE.SchDoc, PressurePulse_Brain-PCB.PrjPcb, Tacile-Buttons.SchDoc]
2024-02-22 Finish routing and finish fencing in RF section. Need to check SD and VBATT pinouts and get RF design review
    [Amplifier.SchDoc, Boost.SchDoc, Fuel-Gauge.SchDoc, MCU-BLE.SchDoc, Magnetic-Charger.SchDoc, PressurePulse_Brain-PCB.PrjPcb, PressurePulse_Brain-PCB_Master.SchDoc]
2024-02-23 All layout is done, awaiting RF design review. Need to replace some parts that JLCPCB is a pain about.
    [Amplifier.SchDoc, Bill of Materials-PressurePulse_Brain-PCB.xlsx, MCU-BLE.SchDoc, PWR-Switch.SchDoc, PressurePulse_Brain-PCB.PrjPcb, Tacile-Buttons.SchDoc, USB-Socket.SchDoc]
2024-02-25 Updating things for CPL
    [Bill of Materials-PressurePulse_Brain-PCB.xlsx, Boost.SchDoc, Flow-Sensor.SchDoc, MCU-BLE.SchDoc, Magnetic-Charger.SchDoc, PWR-Switch.SchDoc, Pressure-Sensor.SchDoc, SD-Socket.SchDoc]
2024-02-26 Brain Mk. I submitted for manufacturing
    [Amplifier.SchDoc, Bill of Materials-PressurePulse_Brain-PCB.xlsx, Boost.SchDoc, Fuel-Gauge.SchDoc, MCU-BLE.SchDoc, PWR-Switch.SchDoc, PressurePulse_Brain-PCB.PrjPcb, SD-Socket.SchDoc]
2024-02-29 Modify RF pi network to use a 0402 inductor. Also remove title blocks from schematic sheets.
    [Amplifier.SchDoc, Boost.SchDoc, Flow-Sensor.SchDoc, Fuel-Gauge.SchDoc, Gyroscope.SchDoc, LDO.SchDoc, MCU-BLE.SchDoc, Magnetic-Charger.SchDoc]
2024-03-12 Pulse PCB Mk. I complete (FR)
    [Gyroscope.SchDoc, MCU-BLE.SchDoc]
